Davidos29/Project_KTANE/3D modely/STL modely/stejná část widgetu.stl

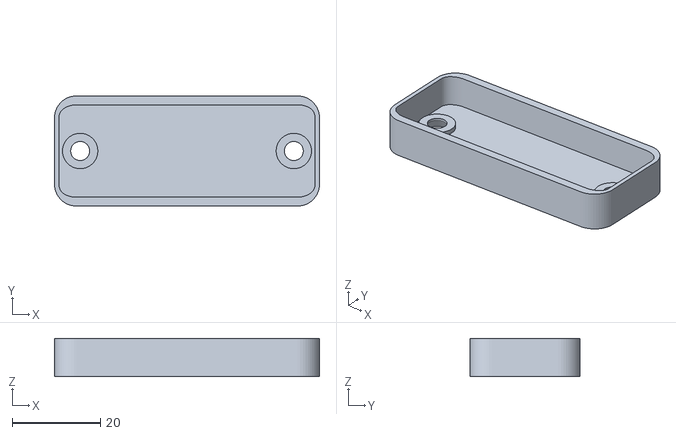
[picture p22: CAD file, 2026-03-29]
3D modely/STL modely/stejná část widgetu.stl
59.9 x 24.9 x 8.70
