Davidos29/Project_KTANE/3D modely/STL modely/Madlo.stl

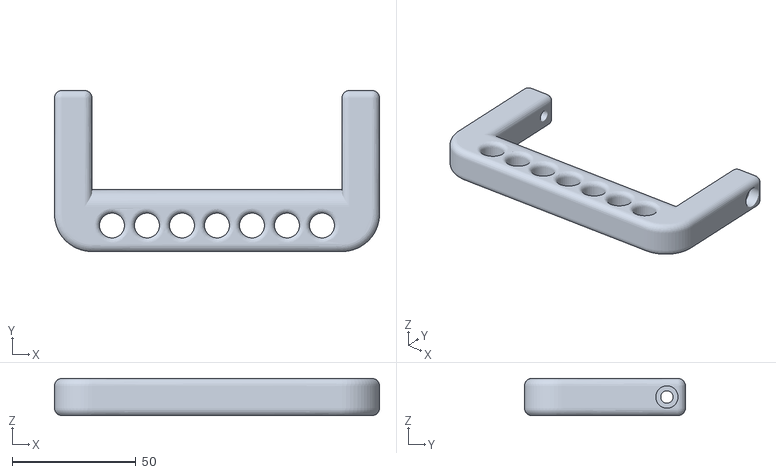
[picture p23: CAD file, 2026-03-29]
3D modely/STL modely/Madlo.stl
131.2 x 65.0 x 15.0
