Davidos29/Project_KTANE/3D modely/STL modely/kolík na prázdný modul.stl

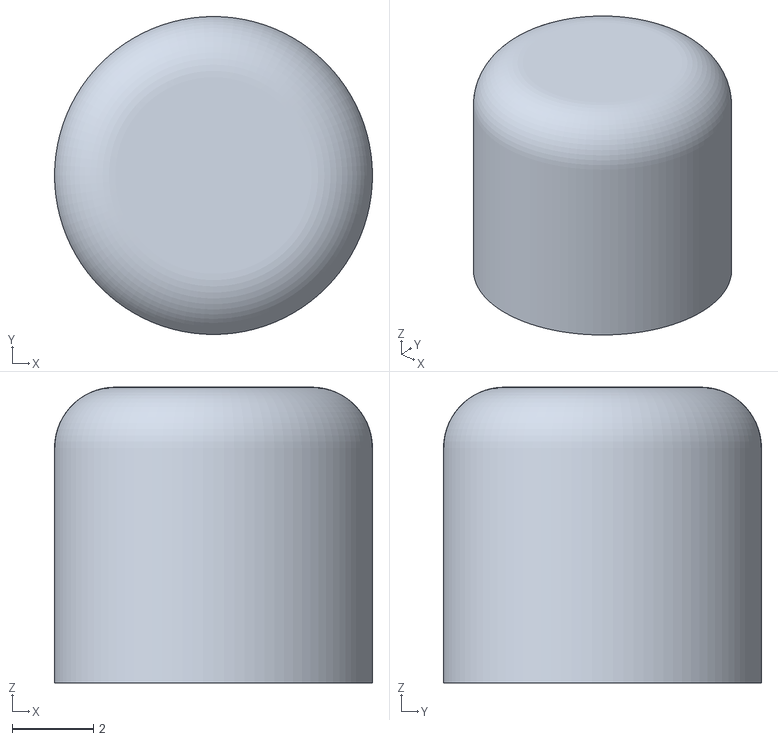
[picture p24: CAD file, 2026-03-29]
3D modely/STL modely/kolík na prázdný modul.stl
7.85 x 7.85 x 7.30
