Davidos29/Project_KTANE/3D modely/STL modely/Madlo2.stl

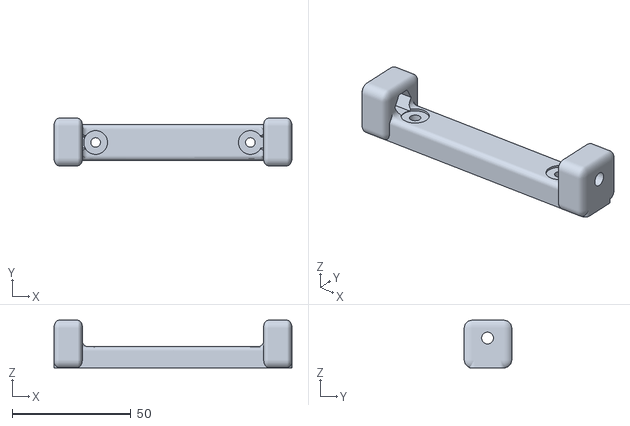
[picture p25: CAD file, 2026-03-29]
3D modely/STL modely/Madlo2.stl
100.0 x 20.0 x 20.0
