Davidos29/Project_KTANE/3D modely/STL modely/vrchní část displeje.stl

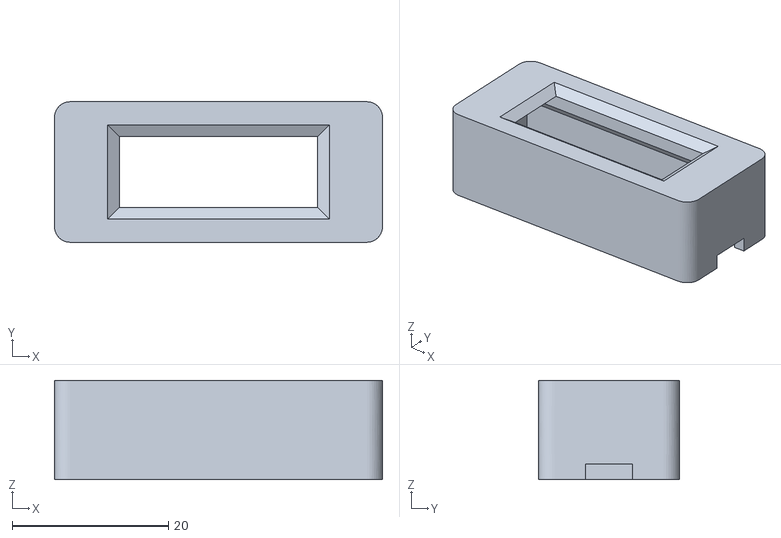
[picture p26: CAD file, 2026-03-29]
3D modely/STL modely/vrchní část displeje.stl
42.0 x 18.0 x 12.7
