Davidos29/Project_KTANE/3D modely/STL modely/Prázdný modul.stl

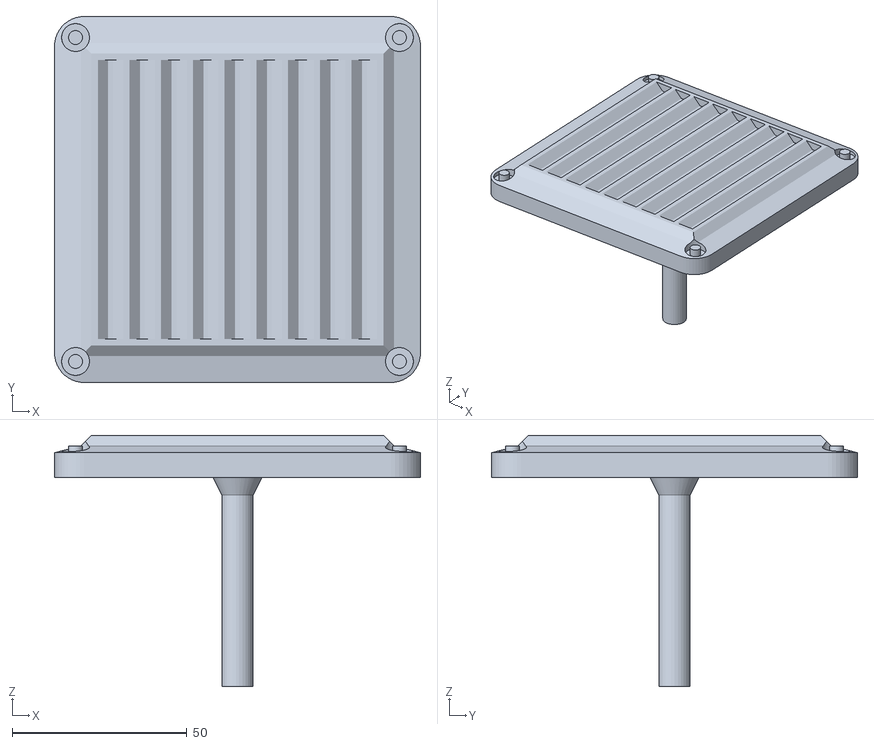
[picture p27: CAD file, 2026-03-29]
3D modely/STL modely/Prázdný modul.stl
104.8 x 104.8 x 72.0
