Davidos29/Project_KTANE/3D modely/STL modely/Tlačítka.stl

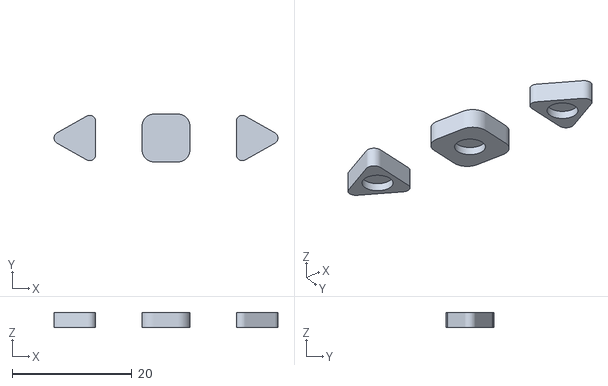
[picture p28: CAD file, 2026-03-29]
3D modely/STL modely/Tlačítka.stl
37.4 x 8.00 x 2.50
