Davidos29/Project_KTANE/3D modely/STL modely/Základní modul.stl

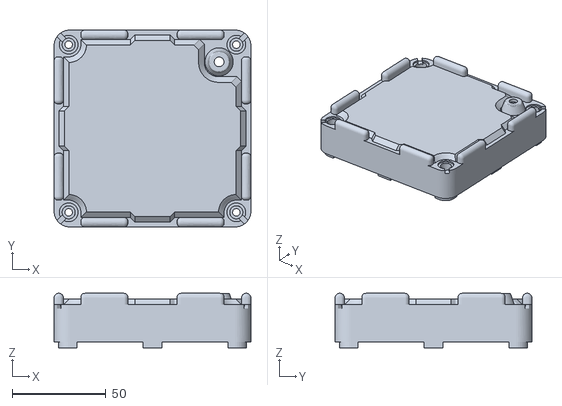
[picture p29: CAD file, 2026-03-29]
3D modely/STL modely/Základní modul.stl
104.8 x 104.8 x 29.0
