Davidos29/Project_KTANE/3D modely/STL modely/krytka nad šroubek.stl

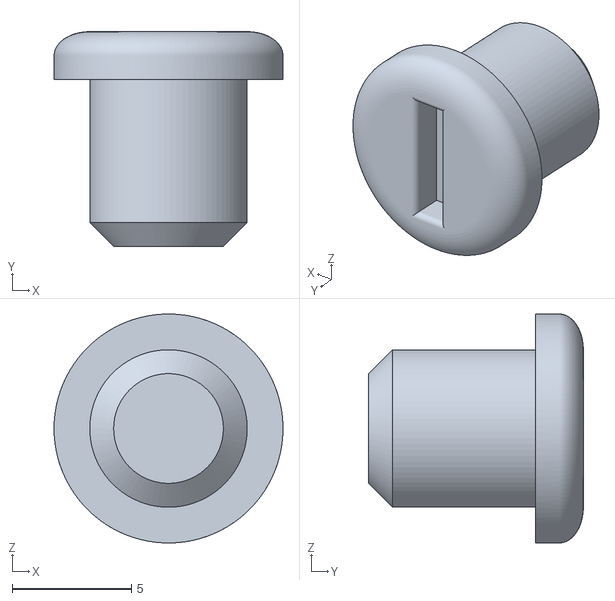
[picture p30: CAD file, 2026-03-29]
3D modely/STL modely/krytka nad šroubek.stl
9.60 x 9.00 x 9.60
