Davidos29/Project_KTANE/3D modely/STL modely/Křížky.stl

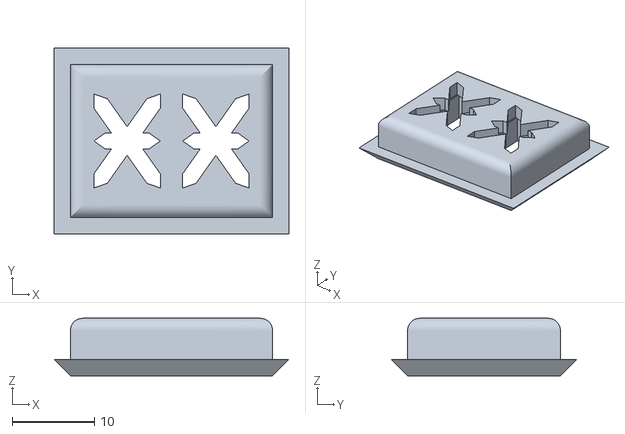
[picture p31: CAD file, 2026-03-29]
3D modely/STL modely/Křížky.stl
28.6 x 22.6 x 7.00
