Davidos29/Project_KTANE/3D modely/STL modely/Modul_dráty.stl

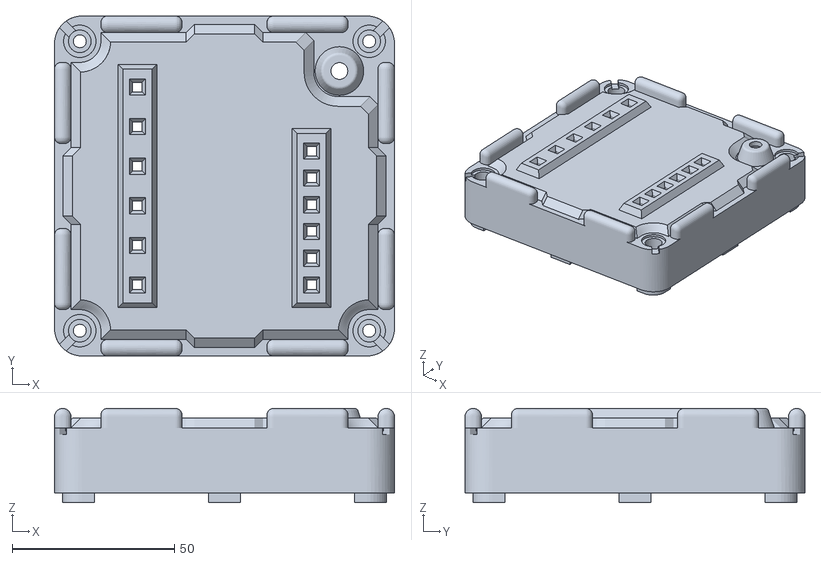
[picture p32: CAD file, 2026-03-29]
3D modely/STL modely/Modul_dráty.stl
104.8 x 104.8 x 29.0
