Davidos29/Project_KTANE/3D modely/STL modely/spodní část displeje.stl

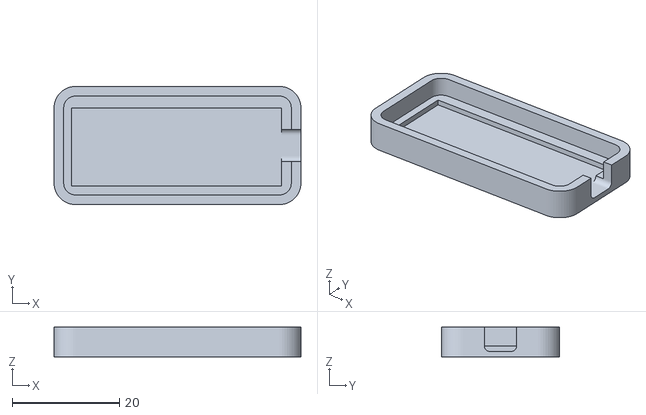
[picture p33: CAD file, 2026-03-29]
3D modely/STL modely/spodní část displeje.stl
46.0 x 22.0 x 5.50
