Davidos29/Project_KTANE/3D modely/STL modely/spodní část widgetu nasazovací.stl

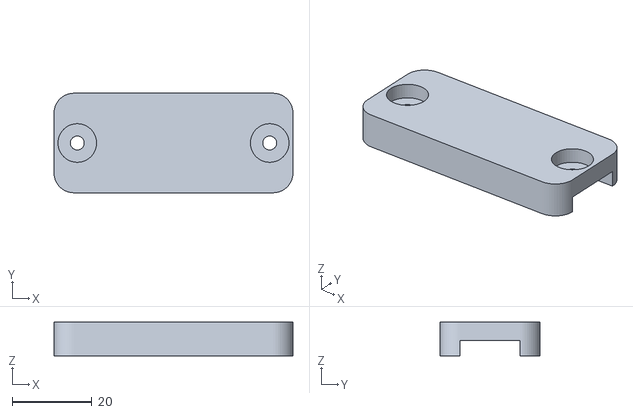
[picture p34: CAD file, 2026-03-29]
3D modely/STL modely/spodní část widgetu nasazovací.stl
60.0 x 25.0 x 8.50
