Davidos29/Project_KTANE/3D modely/STL modely/spodní část widgetu hlavní.stl

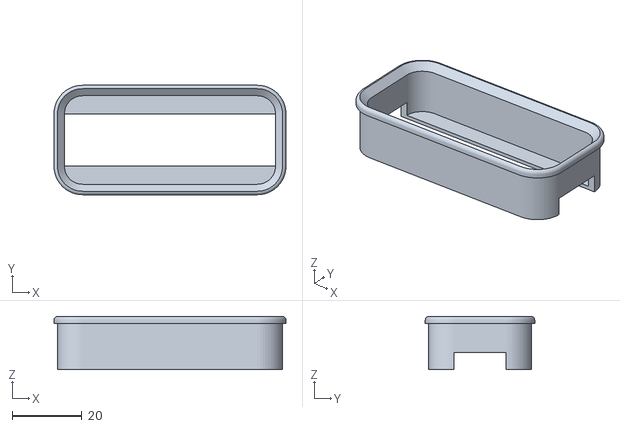
[picture p35: CAD file, 2026-03-29]
3D modely/STL modely/spodní část widgetu hlavní.stl
66.3 x 31.3 x 15.2
