Davidos29/Project_KTANE/(list of files, cad)

Other CAD files:
AutoCAD návrhy/Krabice.dwg
3D modely/Fusion 360 modely/Hlavní modul.f3d
3D modely/Fusion 360 modely/Modul na widgety.f3d
3D modely/Fusion 360 modely/Prázdný modul.f3d
3D modely/Fusion 360 modely/Slot na displej.f3d
3D modely/Fusion 360 modely/Základní modul.f3z
