Davidos29/Project_KTANE/AutoCAD návrhy/Exports/hlavni navrh.pdf

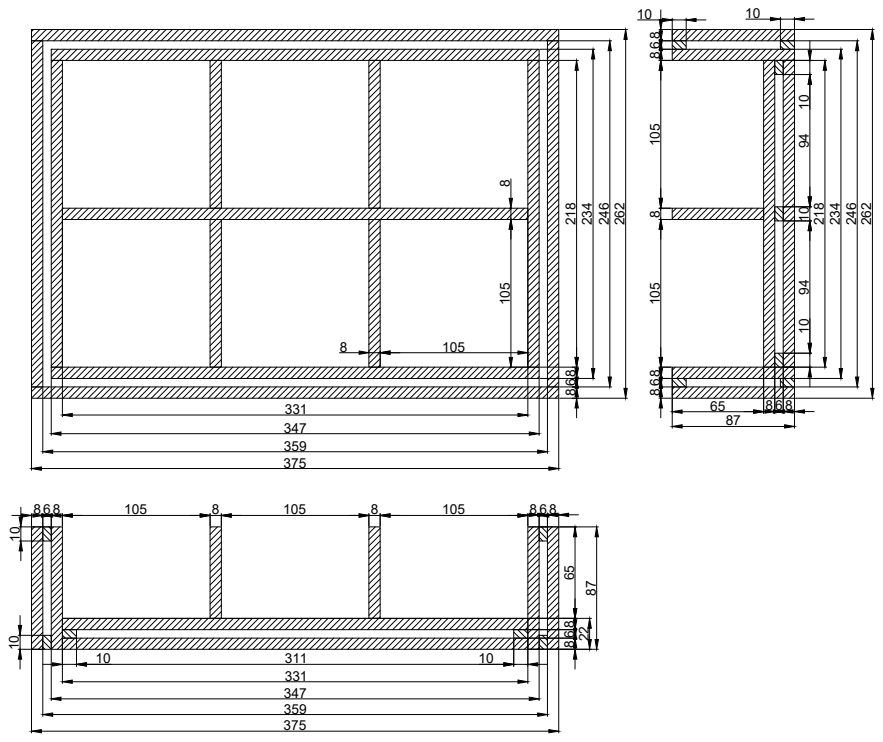
[picture p36: page 1]
