Davidos29/Project_KTANE/AutoCAD návrhy/Exports/jak narezat presne.pdf

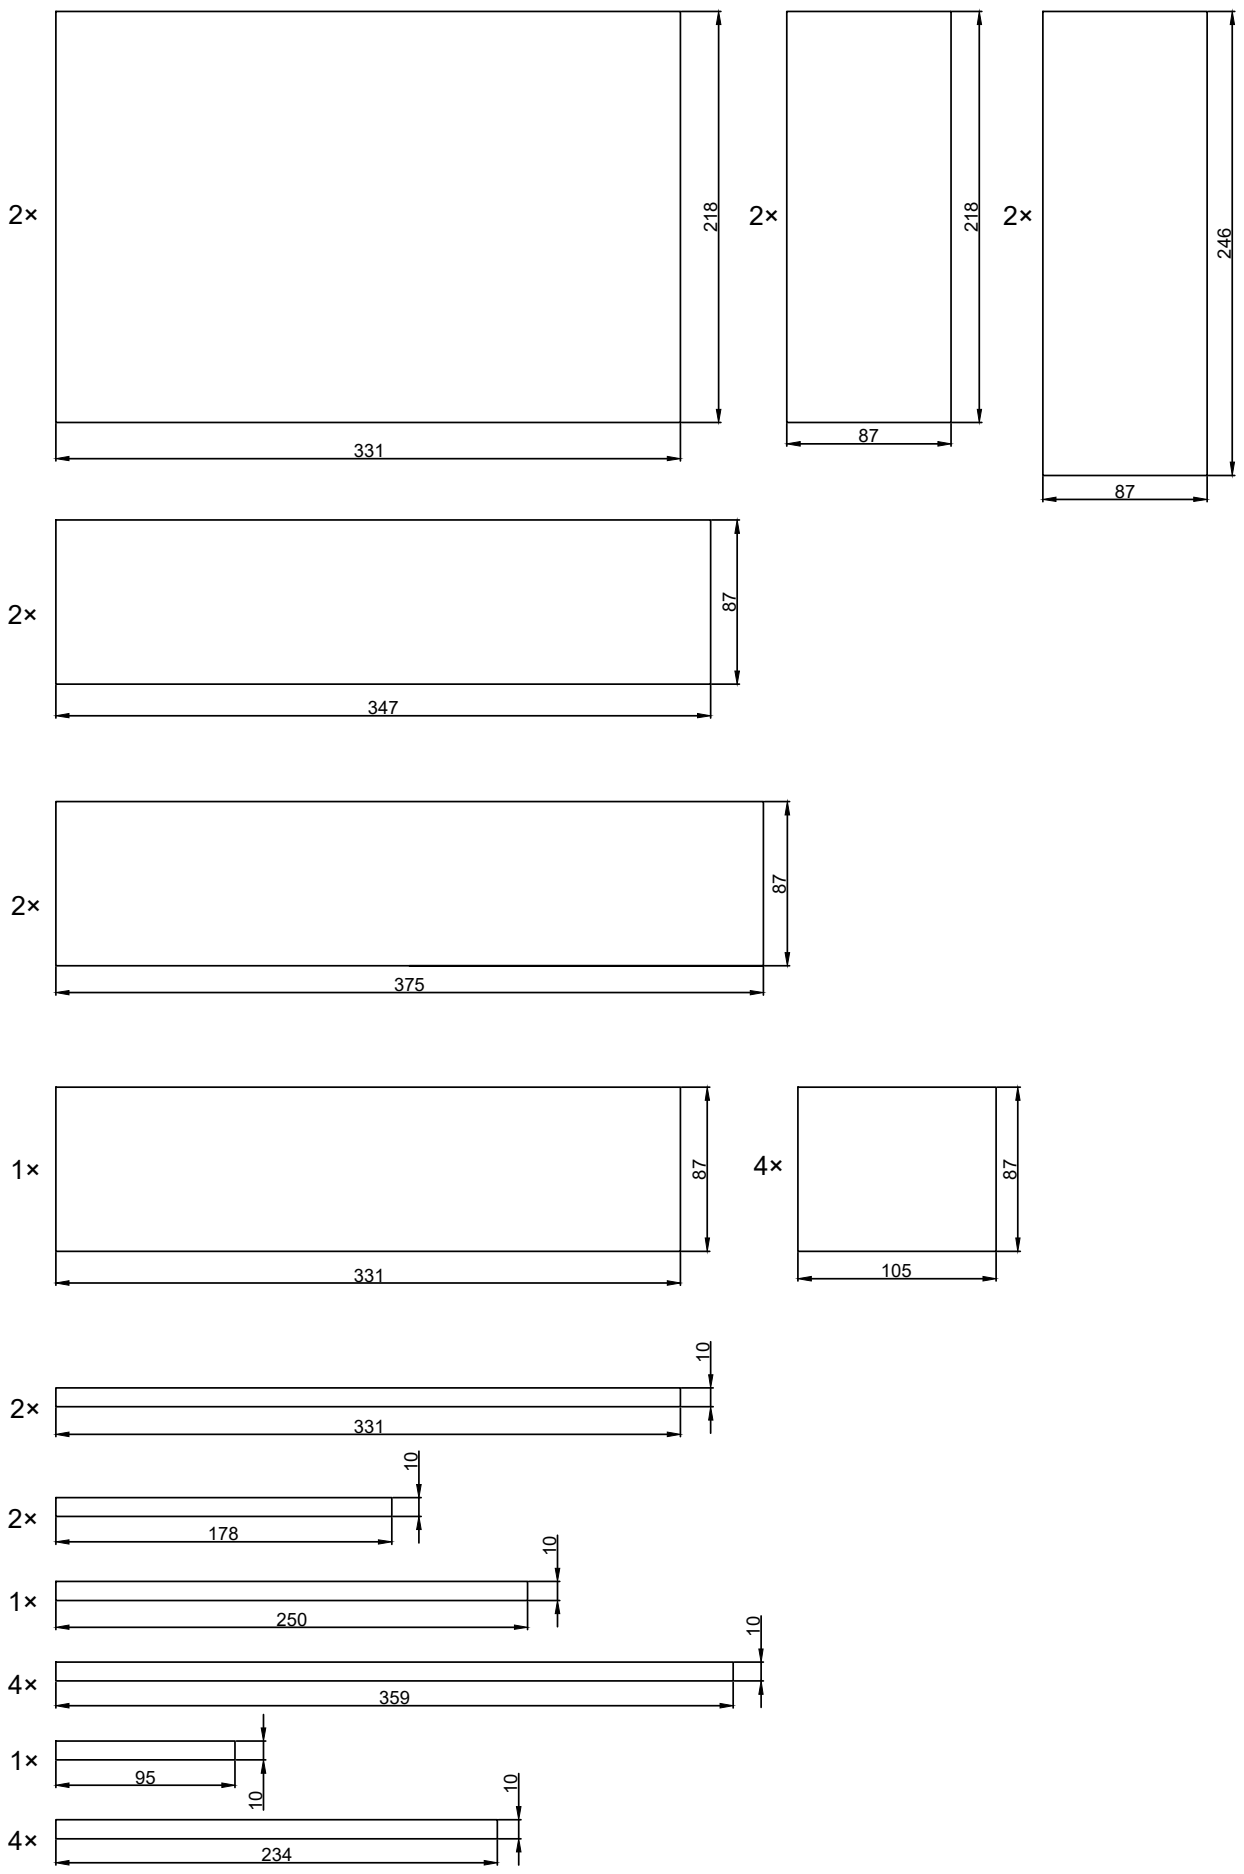
[picture p37: page 1]
