Davidos29/Project_KTANE/AutoCAD návrhy/Exports/jak narezat.pdf

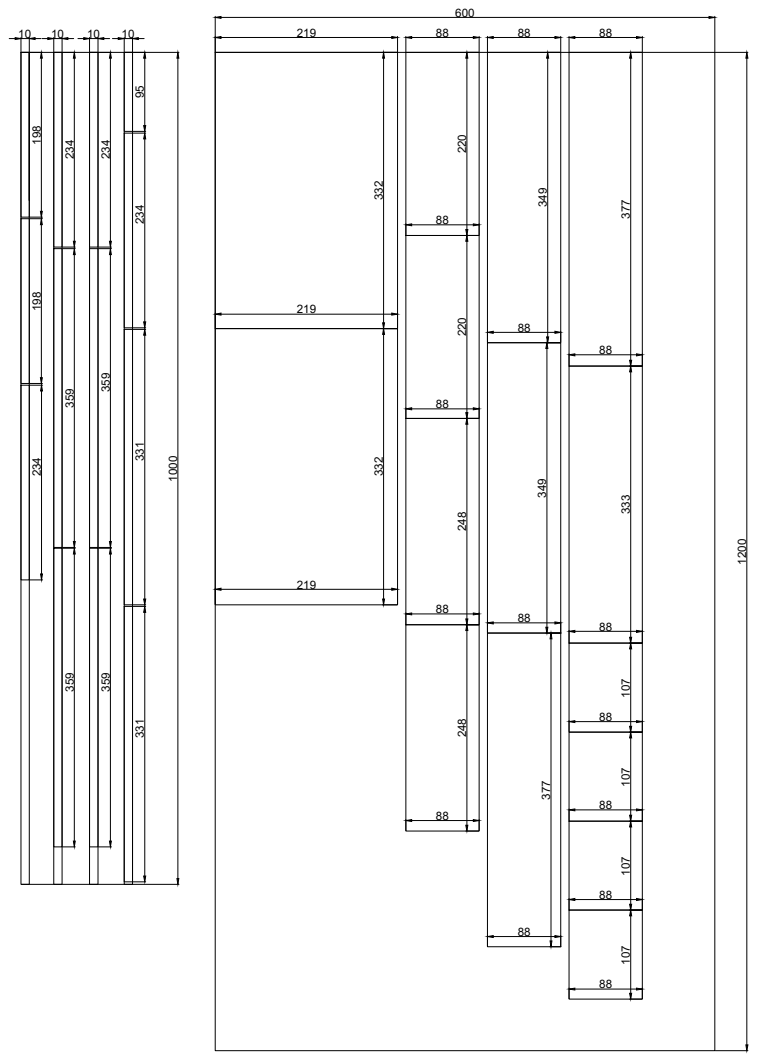
[picture p38: page 1]
