Davidos29/Project_KTANE/AutoCAD návrhy/Exports/stredni vrstva.pdf

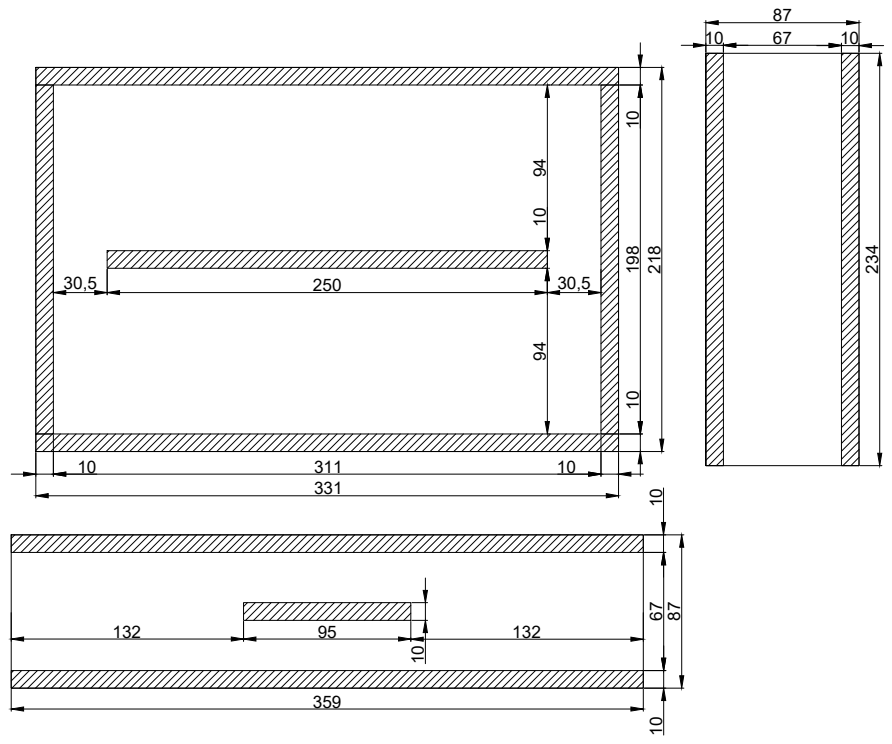
[picture p39: page 1]
